Quadrx/Embedded-AI-System-with-ESP32/hardware/note.txt

KiCad project files for the custom ESP32 PCB.
